luisbenitez-dev/FM-Transmitter/FM TRANSMITTER.asc

C1: cap; 33p
C2: cap; 33p
C3: cap; 33p
C4: cap; 1n
C5: cap; 0.1µ
C6: cap; 0.1µ
L1: ind; 0.1µ; Rser=1m
Q1: npn; 2N2222
Q2: npn; 2N3904
R1: res; 2.2k
R2: res; 10k
R3: res; 4.7k
R4: res; 1.2k
R5: res; 10k
R6: res; 100k
R7: res; 100k
R8: res; 10k
R9: res; 330
R10: res; 10k
V1: voltage; 9
V2: voltage; SINE(0 0.01 1k)
Named nets: 0
.tran 0 50us 45us 0.05n startup
